nourchamas09-crypto/Sensors-Instrumentation--Final-Project-/report/individual_contributions/Hawraa_Diab_6861.md

# Individual Contribution: Hawraa Diab

## Main Responsibilities

My main contributions to this project were focused on the practical implementation and integration of the sensor-based system. I was actively involved during the different development stages, including hardware assembly, manual wiring, sensor integration, programming support, system testing, troubleshooting, and documentation.

I participated in the group work sessions and was present during the assembly, wiring, testing, and debugging phases. My role mainly focused on ensuring that the hardware components were correctly implemented, verifying sensor operation, assisting in solving technical issues, and improving the reliability of the final prototype.

---

# Project Preparation and Hardware Implementation

During the initial preparation phase, I contributed to understanding the system architecture and the role of each sensor and electronic component used in the project.

My contributions included:

- Studying the function and integration requirements of different sensors and modules.
- Participating in the assembly process of the prototype.
- Helping connect the different hardware parts according to the system design.
- Supporting the transition from the theoretical design to the practical implementation.

I was involved in the practical side of the project by helping transform the proposed concept into a functional prototype.

---

# Wiring and Assembly Contribution

I actively participated in the hardware implementation by manually wiring and assembling different parts of the system.

My contributions included:

- Performing manual wiring of sensors, modules, and electronic components.
- Checking and verifying connections between the components and the microcontroller.
- Ensuring correct power supply and signal transmission.
- Assisting in organizing wires and improving the physical arrangement of the prototype.
- Helping assemble and adjust different parts of the system.

Through hands-on work during the assembly sessions, I contributed to making the prototype physically functional and ready for testing.

---

# Programming Contribution

I contributed to the software development and testing process by modifying and analyzing code related to different components of the project.

My programming contributions included:

- Testing codes to verify the operation of sensors and modules.
- Modifying existing code to improve component behavior.
- Testing communication between sensors and the main controller.
- Adjusting parameters and thresholds according to experimental results.

---

# Sensor Testing and Troubleshooting

A significant part of my contribution was dedicated to testing the sensors and identifying technical problems during the development process.

I participated in:

- Testing sensor readings and checking their accuracy.
- Verifying the correct operation of different modules.
- Detecting and analyzing hardware connection problems.
- Debugging software and communication issues.
- Performing repeated tests after modifications.
- Helping determine practical solutions to improve system performance.

I worked with the team to identify the causes of problems and apply corrections to achieve more reliable system behavior.

---

# System Integration and Improvement

During the integration phase, I participated in testing the complete system and verifying the interaction between the different components.

My contributions included:

- Testing the communication between sensors, actuators, and the controller.
- Checking the behavior of the system after combining different modules.
- Assisting in improving the stability and reliability of the prototype.
- Suggesting modifications when unexpected problems occurred.

---

# GitHub Repository and Documentation Contribution

I contributed to organizing and improving the project repository by helping maintain the documentation and project files.

My contributions included:

- Adding and organizing project-related files in the repository.
- Attempting commits and updates to maintain project progress.
- Helping structure documentation related to hardware, software, and testing.
- Adding technical information obtained during implementation and experiments.
- Reviewing repository organization before the final submission.

I helped ensure that the repository contained clear information about the development process and the implemented system.

---

# Final Prototype and Demonstration Contribution

I participated in preparing the final version of the prototype before the demonstration.

My contributions included:

- Verifying sensor and module operation.
- Assisting with final improvements and adjustments.
- Supporting the preparation of the final demonstration.

I remained involved until the final stages to help ensure that the prototype was functional and ready for presentation.

---

# Summary

Overall, my contribution focused on the practical engineering development of the sensor-based project. I actively participated in hardware assembly, manual wiring, sensor testing, programming support, troubleshooting, system integration, and documentation.

Through continuous testing and debugging, I helped identify technical issues, improve system performance, and support the team in developing a functional and reliable final prototype. My involvement covered both the physical implementation of the system and the organization of technical information within the project repository.
