nourchamas09-crypto/Sensors-Instrumentation--Final-Project-/report/individual_contributions/nour_chamas_6890.md

# Individual Contribution: Nour chamas

## Main Responsibilities

My contribution covered project preparation, component purchasing, continuous attendance during group work sessions, hardware assembly support, sensor testing and troubleshooting, final robot appearance, presentation video filming/editing, and GitHub documentation organization.

---

## Project Preparation

At the beginning of the project, I helped slightly adjust the initial project plan based on the components that were available and the practical needs of the robot.

I also bought the main project components from the store and later purchased missing or replacement parts when some components were not working properly or needed to be replaced.

---

## Hardware Contribution

I was present during all group work sessions related to the project, including assembly, wiring, testing, troubleshooting, and final preparation.

I participated in almost all physical work on the robot, except mainly the motor driver and wheel installation. I was involved in the general wiring, testing, sensor debugging, final adjustments,

My hardware contribution included:

- Bringing the main components from the store.
- Buying missing components during the project.
- Buying replacement parts for components that stopped working or caused problems.
- Assisting during the wiring and assembly of the robot.
- Helping with the final physical form of the robot.
- Assisting in preparing the external container/cover of the car.

I was involved in most of the hardware work except for the motor driver and wheel installation.

---

## Testing and Troubleshooting

I participated in testing and troubleshooting several parts of the system during development.

This included working on issues related to:

- Flame sensor calibration.
- Switching the flame sensor from digital output to analog output.
- Using Serial Monitor readings to adjust the flame sensor threshold.
- Flow sensor leakage and fixing its connection.
- Ultrasonic sensor voltage divider issues.
- Line tracking sensor instability.
- Servo motor testing and debugging.
- Relay and pump behavior.
- LCD display status.
- Bluetooth control testing.

I also helped test the robot behavior during integration, including fire detection, pump activation, servo behavior, and movement control.

---

## Final Prototype and Demo Contribution

I helped prepare the final physical appearance of the robot, including the container/cover used on the car.

I also handled the filming and editing of the presentation/demo video. This included showing the robot components, recording the robot behavior, organizing the clips, and preparing the final video format for the presentation.

The video preparation was important because it helped present the project clearly and showed the function of the main sensors and components.

- LCD readings.
- Bluetooth movement control.
- Line tracking behavior.
- Obstacle detection.
- Flame detection.
- Pump activation.
- Servo/nozzle behavior.

---

## Documentation Contribution

I contributed to organizing and preparing the GitHub documentation by working on the project files and reviewing what needed to be included.

This included helping prepare or organize:

- Repository structure.
- Pinout and wiring information.
- System architecture notes.
- Troubleshooting notes.
- Test code files.
- Demo/video documentation.
- Contribution documentation.

---
Personal Reflection

This project helped me understand how much work is needed to move from an idea to a working prototype. I learned that hardware projects require repeated testing, debugging, and replacing or adjusting components when they do not work as expected.

I also learned the importance of documenting the process, because many important project decisions came from troubleshooting.

Overall, I contributed by preparing and purchasing project components, supporting the group during assembly, wiring, testing, and troubleshooting, helping with the final physical design of the robot, recording the demonstration video, and helping organize the GitHub documentation for the final submission.
