nourchamas09-crypto/Sensors-Instrumentation--Final-Project-/docs/circuit_diagram.pdf

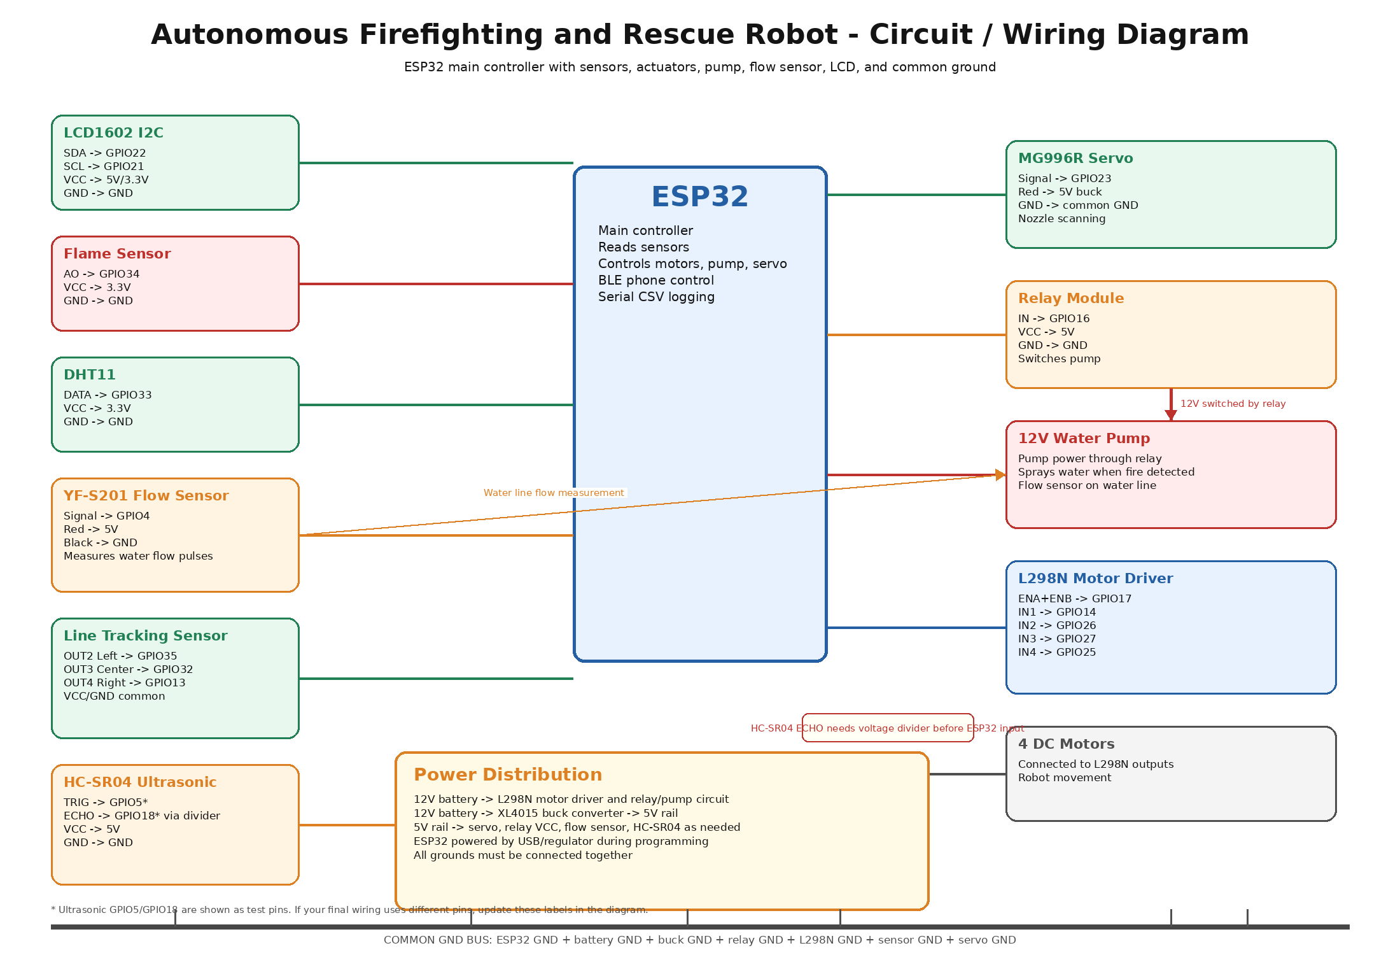
[picture p12: page 1]
