nourchamas09-crypto/Sensors-Instrumentation--Final-Project-/(commit log)

2026-07-14 Update and rename bom.md to bill-of-material.md
2026-07-14 Add ESP32 firmware code
2026-07-14 add wiring notes
2026-07-14 Add 60 second demo log
    [demo_log_60s.csv]
2026-07-14 servo test code
2026-07-14 ultrasonic sensor test code
2026-07-14 Add flame sensor test code
2026-07-15 Add individual contribution report for Hawraa Diab
    Detailed contributions by Hawraa Diab to the sensor-based project, covering responsibilities in hardware implementation, wiring, programming, testing, system integration, and documentation.
